mkgeiger/secure-keyless-system/(commit log)

2024-10-09 Add KeylessClient including HW parts and schematic
2024-10-09 Add KeylessServer source code for Raspberry PI Zero
2024-10-10 Raspberry PI Zero W picture added
2024-10-10 Raspberry Pi Zero W component added
2024-10-14 Step-up voltage regulator chapter added
2024-10-14 Schematic chapter added
2024-10-16 Chain of Trust image added
2024-10-16 Chain Of Trust chapter added
